johnhmacleod/vibe/hardware/circuit.jpg

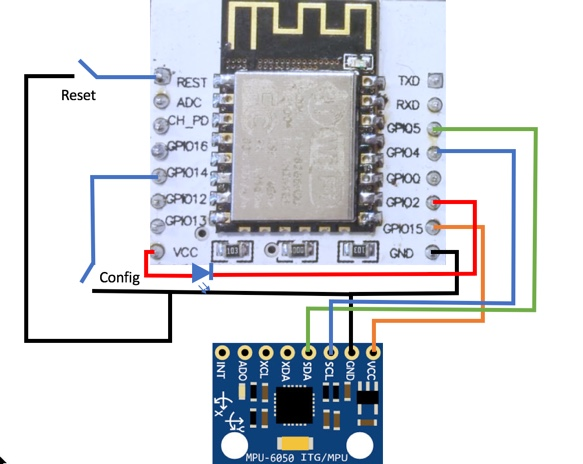
hardware/circuit.jpg
