johnhmacleod/vibe/hardware/parts.md

Power (depending on choice for power supply)

https://www.aliexpress.com/item/1x-HLK-PM01-AC-DC-220V-to-5V-Step-Down-Power-Supply-Module-Household-Switch-VEB73/32762556380.html)

https://www.aliexpress.com/item/Free-Shipping-DC-to-DC-4V-38V-to-1-25V-36V-5A-Step-Down-Power-Supply/32381913950.html

https://www.aliexpress.com/item/10x-New-Spring-Clip-Black-Plastic-3-x-1-5V-AA-Battery-Case-Slot-Holder/32808424976.html

https://www.aliexpress.com/item/50pcs-SOT89-To-DIP-SOT223-To-DIP-Adapter-Board-Transfer-Plate-Pinboard-1-5mm-Pitch-Pin/32787267814.html

https://www.aliexpress.com/item/20pcs-lot-XC6206P332PR-XC6206P332-XC6206-3-3V-SOT-89/32701818048.html

Processor (use bare ESP8266 when battery powered)

https://www.aliexpress.com/item/10PCS-ESP-12S-ESP-12F-upgrade-ESP8266-remote-serial-Port-WIFI-wireless-module-2016-New-version/32798766735.html

https://www.aliexpress.com/item/10pcs-lot-ESP8266-serial-WIFI-module-adapter-plate-Applies-to-ESP-07-ESP-08-ESP-12/32391714840.html

Vibration/Temperature Sensor

https://www.aliexpress.com/item/MPU-6050-3-Axis-gyroscope-acce-lerometer-module-3V-5V-compatible-For-Arduino/2035920870.html

Plug & Socket

https://www.aliexpress.com/item/GX12-2-3-4-5-6Pin-12mm-M12-Male-Female-Panel-Metal-Connector-Aviation-Plug-10Pcs/32763105384.html

Switches

https://www.aliexpress.com/item/10Pcs-Black-Mini-Miniature-Momentary-On-Off-Lockless-Micro-Push-Button-Switches-2pins-0-5A-Useful/32805065753.html
