johnhmacleod/vibe/src/FFT_01_CONFIG_DS/Debug.ino

void PrintVector(double *vData, uint8_t bufferSize, uint8_t scaleType)
{
  for (uint16_t i = 0; i < bufferSize; i++)
  {
    double abscissa;
    /* Print abscissa value */
    switch (scaleType)
    {
      case SCL_INDEX:
        abscissa = (i * 1.0);
  break;
      case SCL_TIME:
        abscissa = ((i * 1.0) / samplingFrequency);
  break;
      case SCL_FREQUENCY:
        abscissa = ((i * 1.0 * samplingFrequency) / samples);
  break;
    }
    Serial.print(abscissa, 6);
    Serial.print(" ");
    Serial.print(vData[i], 4);
    Serial.println();
  }
  Serial.println();
}
