johnhmacleod/vibe/(commit log)

2017-06-26 Add node red flow
2017-07-14 Update Spiffs.ino
    Explain new ESP8266 reset requirements
    [Spiffs.ino]
2017-07-17 Add circuit
